iury-igd1/2202_SmartWay/hardware/pulseira_2202_base.stl

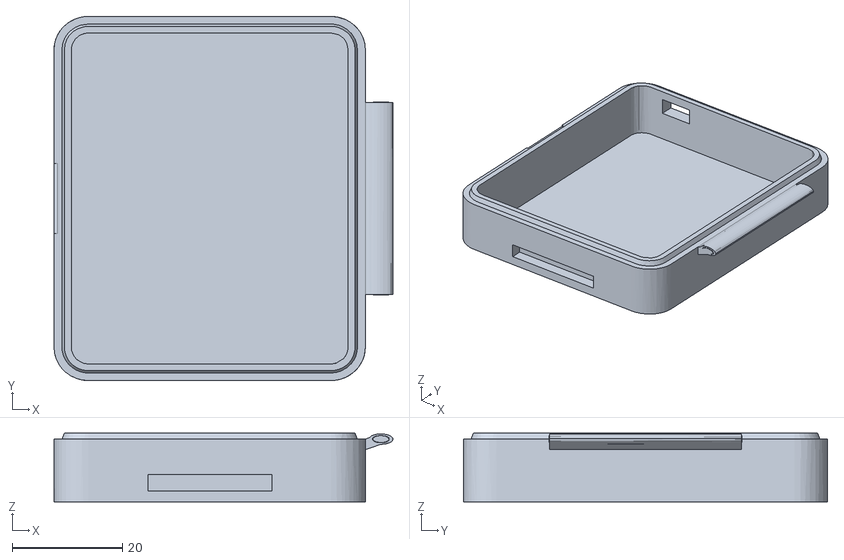
[picture p1: CAD file, 2026-11-04]
hardware/pulseira_2202_base.stl
61.4 x 66.0 x 12.5
