iury-igd1/2202_SmartWay/hardware/pulseira_2202_topo.stl

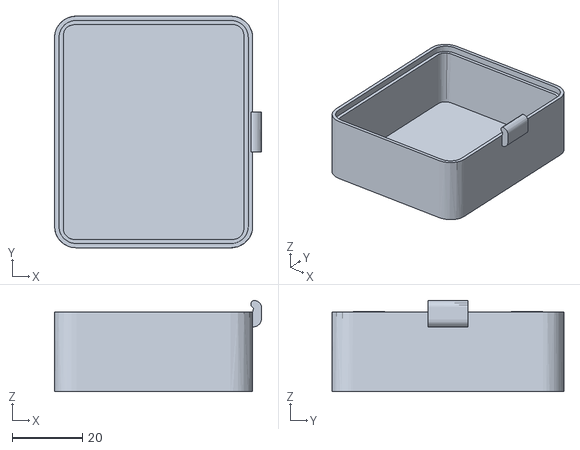
[picture p2: CAD file, 2026-11-04]
hardware/pulseira_2202_topo.stl
58.9 x 66.0 x 26.0
