iury-igd1/2202_SmartWay/hardware/pulseira2202.brd

## EAGLE design hardware/pulseira2202.brd (2026-11-04)

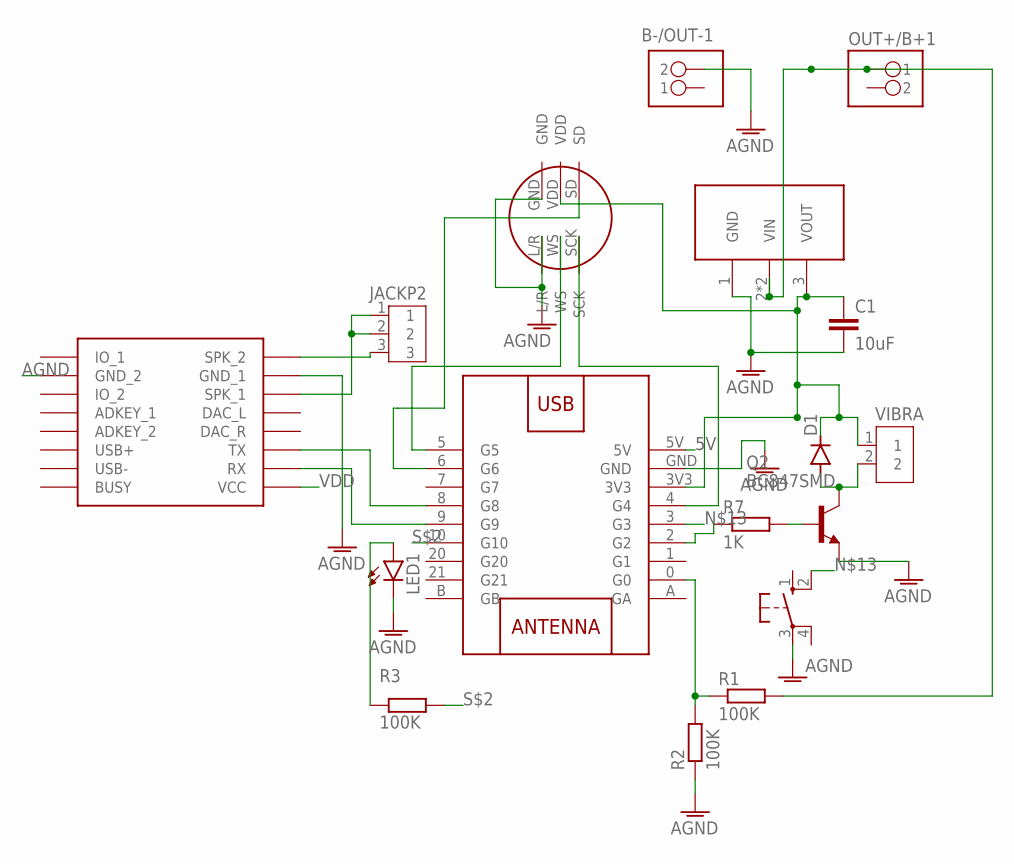
[picture p3: schematic pulseira2202.sch]

Parts:
B-/OUT-1: PINHD-1X02_1X02M; 1X02
C1: 10uF; C0805
D1: DIODE-SOD123; SOD123
IC1: HT7833; SOT89
JACKP2: B3B-XH-A
LED1: LED3MM
OUT+/B+1: PINHD-1X02_1X02M; 1X02
Q2: BC847SMD; SOT23
R1, R2, R3: 100K; R0805
R7: 1K; R0805
S1: 10-XX; B3F-10XX
U$1: DFPLAYER
U$2: INMP441_CIRCULAR; MIC_CIRCULAR
U$4: ESP32SUPERMINI_ESP32-SUPERMINI
VIBRA: B2B-XH-A

Connections:
5V: U$4.5V
AGND: B-/OUT-1.2, C1.2, IC1.1 (GND), LED1.K (C), Q2.2 (E), R2.1, S1.3, U$1.GND_1, U$1.GND_2, U$2.GND, U$2.L/R, U$4.GND
unnamed: U$1.RX, U$4.9 (G9)
unnamed: U$1.TX, U$4.8 (G8)
unnamed: JACKP2.1, JACKP2.2, U$1.SPK1 (SPK_1)
unnamed: JACKP2.3, U$1.SPK2 (SPK_2)
unnamed: Q2.1 (B), R7.2
unnamed: R7.1, U$4.2 (G2)
unnamed: D1.A, Q2.3 (C), VIBRA.2
unnamed: U$2.WS, U$4.5 (G5)
unnamed: U$2.SCK, U$4.4 (G4)
unnamed: U$2.SD, U$4.6 (G6)
unnamed: S1.2 (S1), U$4.3 (G3)
unnamed: IC1.2 (VIN), IC1.2@1 (VIN), OUT+/B+1.1, R1.2
unnamed: R1.1, R2.2, U$4.0 (G0)
S$1: LED1.A, R3.2
S$2: R3.1, U$4.10 (G10)
VDD: C1.1, D1.C, IC1.3 (VOUT), U$1.VCC, U$2.VDD, U$4.3V3, VIBRA.1

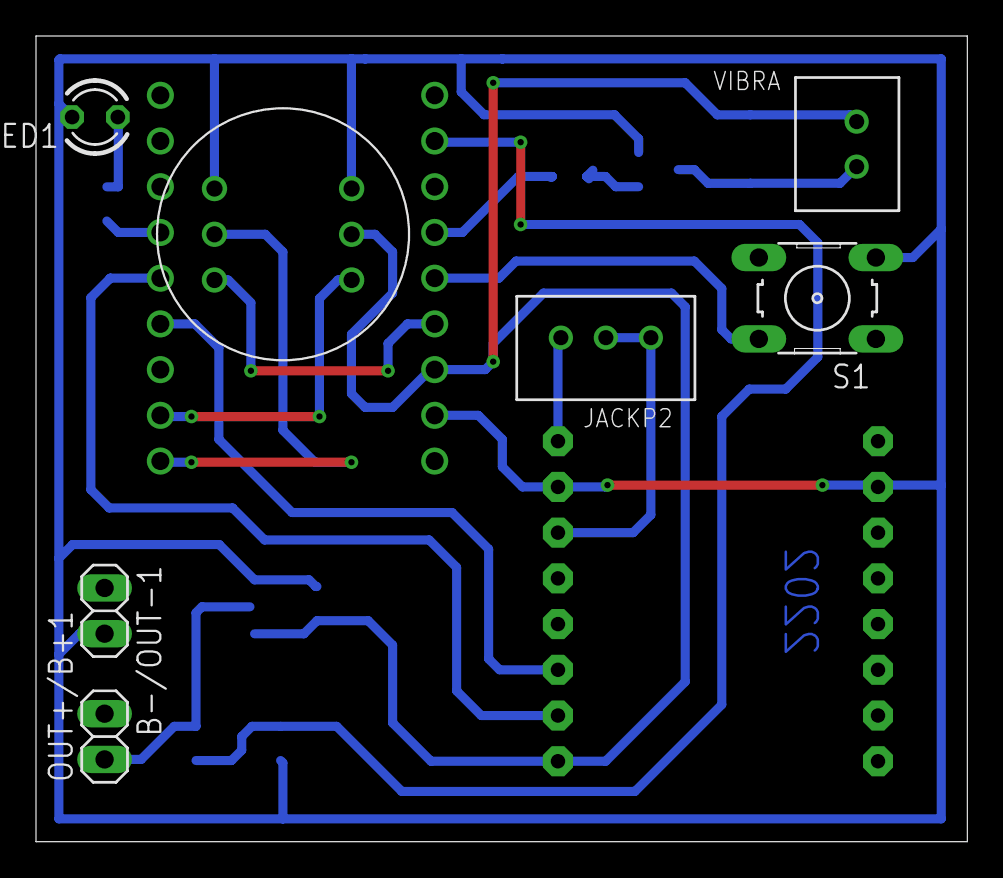
[picture p4: board pulseira2202.brd from above]

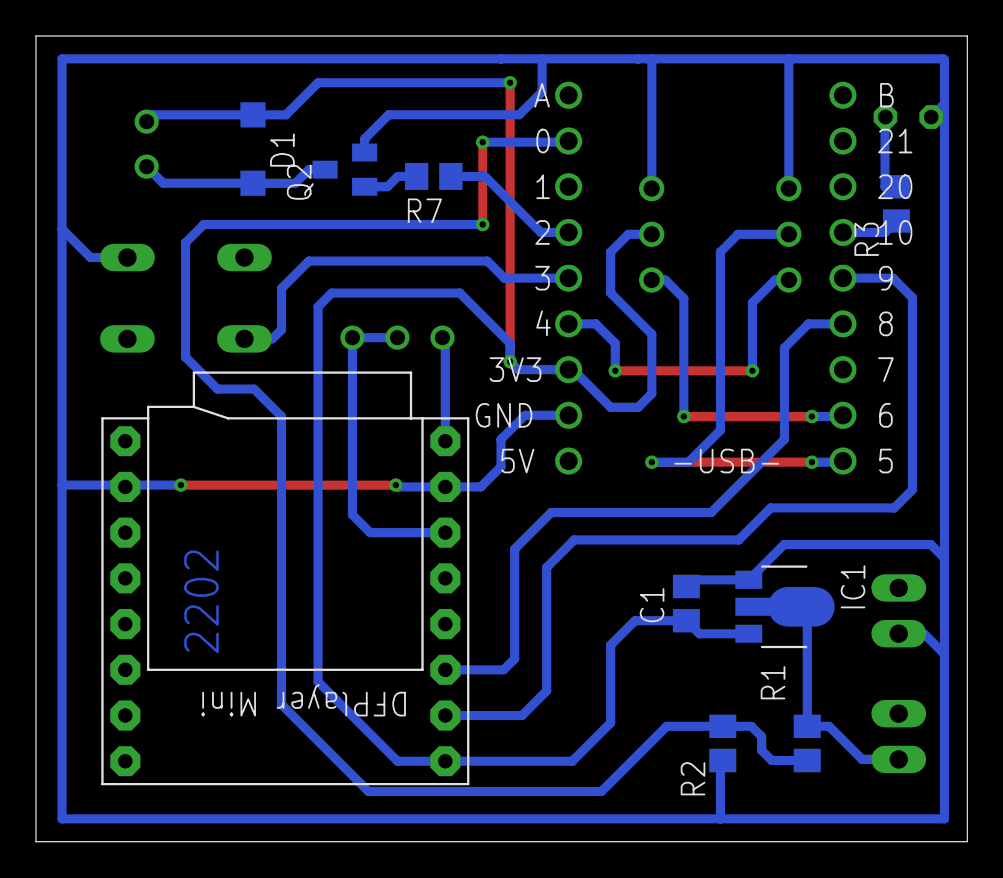
[picture p5: board pulseira2202.brd from below]

Board: 2 copper layers, 51.7 x 44.8 mm, 17 parts (10 on the bottom side), 17 nets.
